jorikdima/pool/case/pcb.FCStd

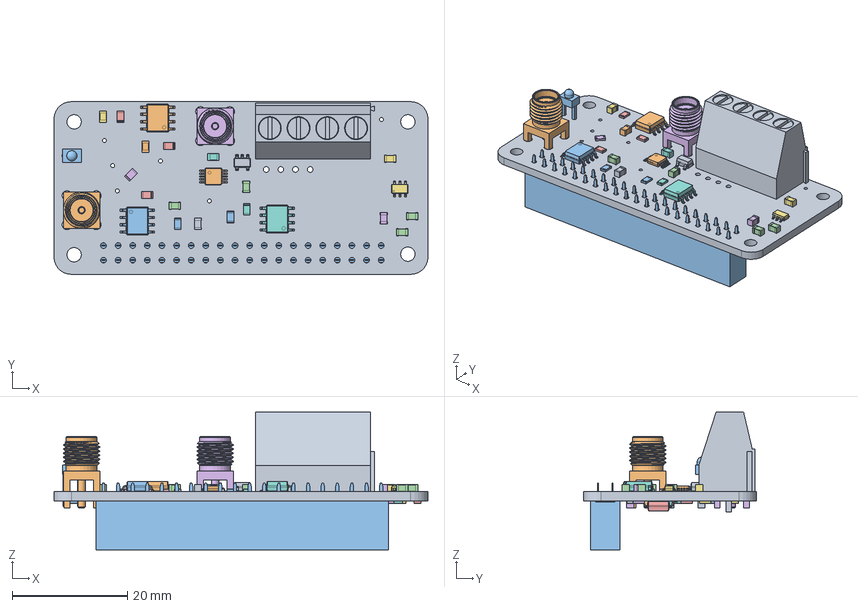
[picture p2: CAD file, 2026-05-02]
case/pcb.FCStd
65.0 x 30.0 x 23.9 mm
Pcb_4311
J2_SMA_Amphenol_132134-11_Vertical_72661cf283ca
D1_LED_D1.8mm_W3.3mm_H2.4mm_6bf1fc921708
C8_C_0805_2012Metric_d904a494b3f4
R5_R_0805_2012Metric_8d37b84ecc4e
C2_C_0805_2012Metric_3a2e4188a297
C5_C_0805_2012Metric_8c90f64f1577
C11_C_0805_2012Metric_bafed0a6da60
J5_TerminalBlock_Phoenix_MKDS_15_4_1x04_P500mm_Horizontal_b8ce8e763538
C9_C_0805_2012Metric_7eb5338fcb41
U2_SOIC-8_3.9x4.9mm_P1.27mm_2550f2f39244
C10_C_0805_2012Metric_abaf07eaa9fc
R7_R_0805_2012Metric_e9da5239a126
J1_SMA_Amphenol_132134-11_Vertical_2cd8d22345b4
C3_C_0805_2012Metric_82abfd312ff3
R16_R_0805_2012Metric_f6691c26e6cb
C6_C_0805_2012Metric_9fc1de177a4e
U1_SOIC-8_3.9x4.9mm_P1.27mm_51985abbd5b2
R8_R_0805_2012Metric_dedefeaef5dd
C4_C_0805_2012Metric_889bce21aff5
R6_R_0805_2012Metric_2ebd9e4347ab
R9_R_0805_2012Metric_04fef424d517
U6_TSOT-23-6_4b1aacd5f09c
U7_SOIC-8_3.9x4.9mm_P1.27mm_beb94b351340
U3_SOT-23-5_a0721606ffa5
U4_TSSOP-10_3x3mm_P0.5mm_04ffdf737e38
R15_R_0805_2012Metric_ebe37478ae97
C1_C_0805_2012Metric_9191a875fa58
U5_SOIC-8_3.9x4.9mm_P1.27mm_6b1703b95a7e
R1_R_0805_2012Metric_da51b3c93e23
R10_R_0805_2012Metric_213238f415b5
R4_R_0805_2012Metric_9aad4cd79e26
R17_R_0805_2012Metric_6fbff45f6105
R12_R_0805_2012Metric_07551a44a8e4
R13_R_0805_2012Metric_59f227cf37c0
R11_R_0805_2012Metric_712be630412e
R3_R_0805_2012Metric_37c15d3d4615
C13_C_0805_2012Metric_2cca7952e8c8
R2_R_0805_2012Metric_f6ddbbc95152
C12_C_0805_2012Metric_ab900ac9c869
C7_C_0805_2012Metric_8e6ad15c78c4
C14_C_0805_2012Metric_feff4e1ea039
J4_PinSocket_2x20_P2.54mm_Vertical_2164e223c993
