jorikdima/pool/(list of files, drawings)

Other design files:
board/sbvm925/TLV75801P_TRANS.DSN
board/sbvm925/TLV75801P_TRANS.OLB
board/sbvm925/TLV75801P_TRANS.opj
board/TLV2372_PSPICE_AIO/TLV2372.DSN
board/TLV2372_PSPICE_AIO/TLV2372.OLB
board/TLV2372_PSPICE_AIO/TLV2372.opj
