jorikdima/pool/board/pool/pool.kicad_pcb

## KiCad design board/pool/pool.kicad_pcb (2026-05-03)

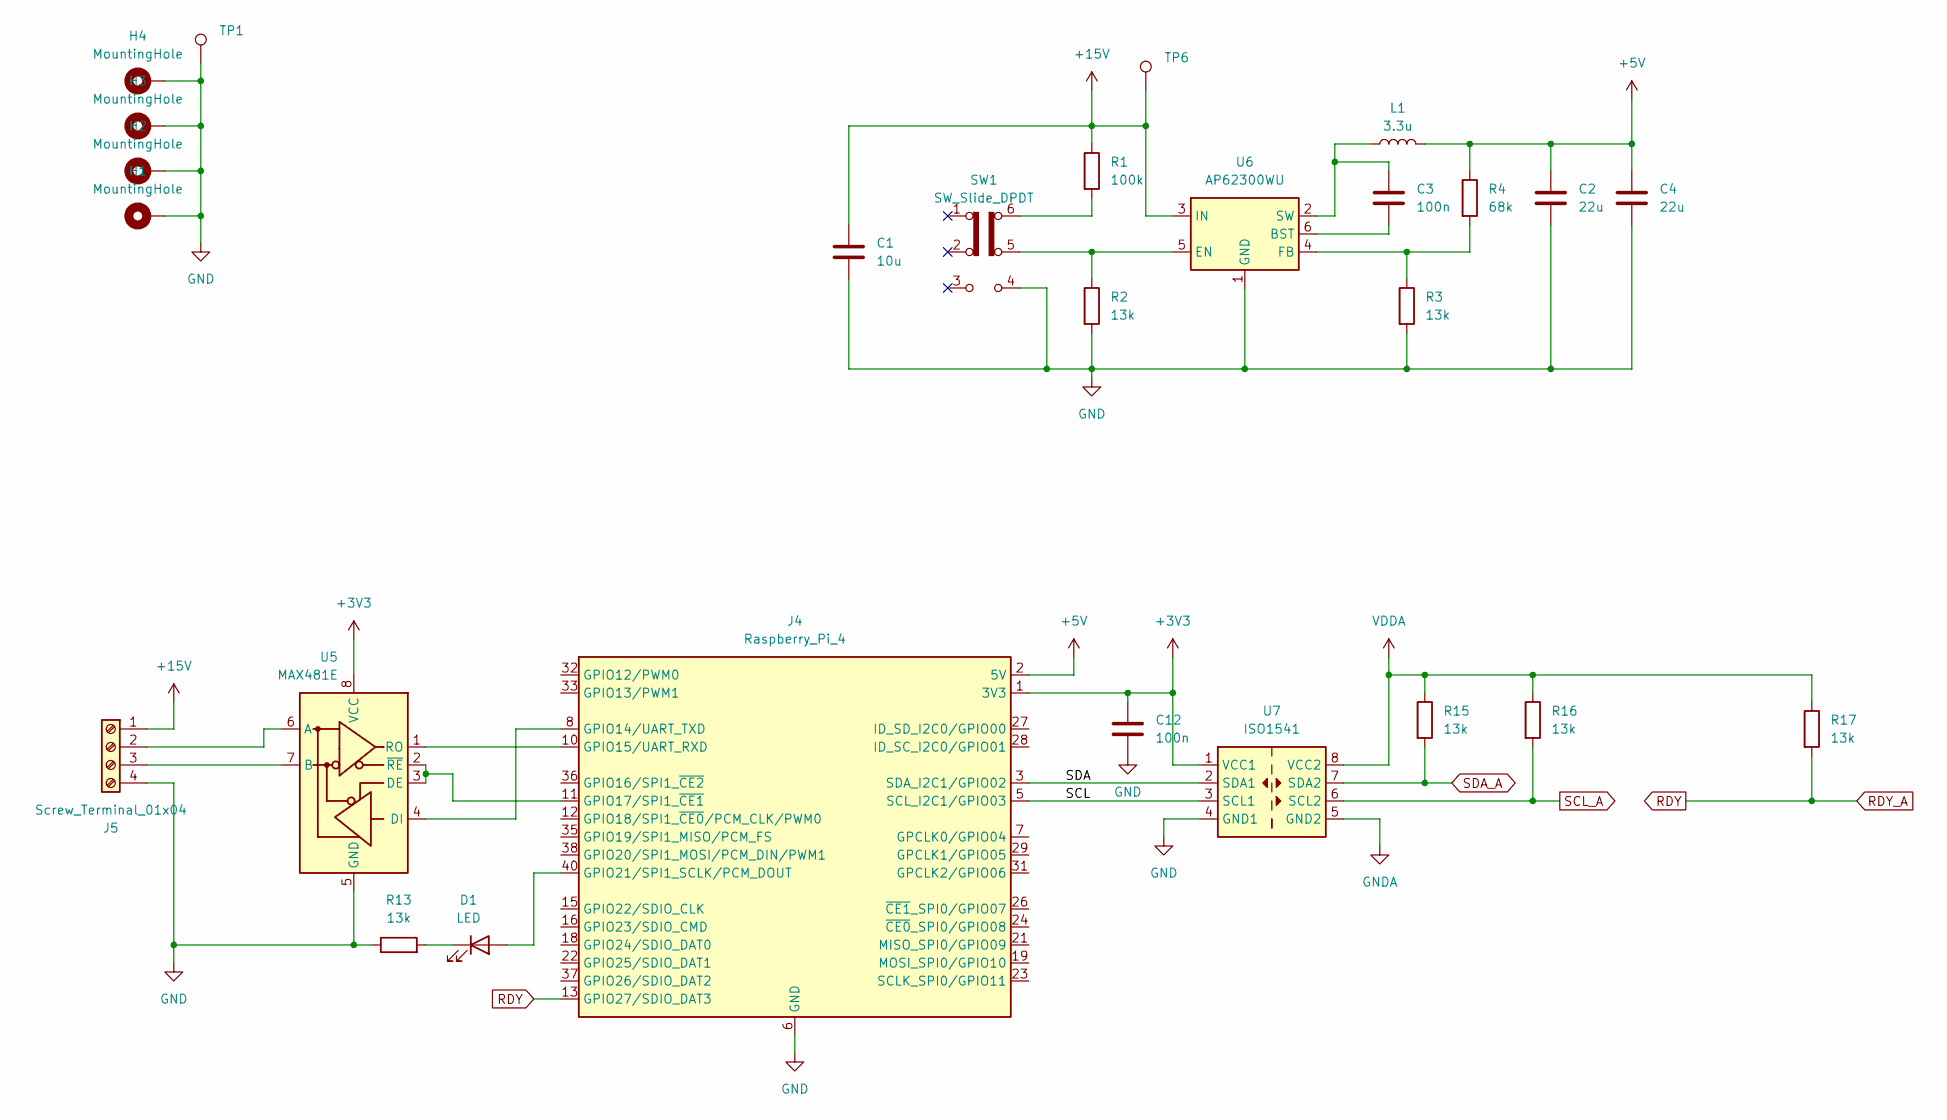
[picture p3: schematic digital.kicad_sch]

Parts:
C1: 10u; C_0805_2012Metric_Pad1.18x1.45mm_HandSolder
C2, C4: 22u; C_0805_2012Metric_Pad1.18x1.45mm_HandSolder
C3, C12: 100n; C_0805_2012Metric_Pad1.18x1.45mm_HandSolder
D1: LED; LED_D1.8mm_W3.3mm_H2.4mm
H1, H2, H3, H4: MountingHole; MountingHole_2.5mm_Pad_TopBottom
J4: Raspberry_Pi_4; PinSocket_2x20_P2.54mm_Vertical
J5: Screw_Terminal_01x04; TerminalBlock_Phoenix_MKDS-1,5-4_1x04_P5.00mm_Horizontal
L1: 3.3u; L_Taiyo-Yuden_NR-80xx_HandSoldering
R1: 100k; R_0805_2012Metric_Pad1.20x1.40mm_HandSolder
R2, R3, R13, R15, R16, R17: 13k; R_0805_2012Metric_Pad1.20x1.40mm_HandSolder
R4: 68k; R_0805_2012Metric_Pad1.20x1.40mm_HandSolder
SW1: SW_Slide_DPDT; CL-SB-22A
TP1: TestPoint; TestPoint_Pad_2.0x2.0mm
TP6: TestPoint; TestPoint_THTPad_1.5x1.5mm_Drill0.7mm
U5: MAX481E; SOIC-8_3.9x4.9mm_P1.27mm
U6: AP62300WU; TSOT-23-6
U7: ISO1541; SOIC-8_3.9x4.9mm_P1.27mm

Connections:
+3V3: C12.1, J4.1 (3V3), J4.17 (3V3), U5.8 (VCC), U7.1 (VCC1)
+5V: C2.1, C4.1, J4.2 (5V), J4.4 (5V), L1.2, R4.1; also elsewhere on the board
+15V: C1.1, J5.1, R1.1, TP6.1, U6.3 (IN)
/digital/SCL: J4.5 (SCL_I2C1/GPIO03), U7.3 (SCL1)
/digital/SDA: J4.3 (SDA_I2C1/GPIO02), U7.2 (SDA1)
GND: C1.2, C2.2, C4.2, C12.2, H1.1, H2.1, H3.1, H4.1, J4.6 (GND), J4.9 (GND), J4.14 (GND), J4.20 (GND), J4.25 (GND), J4.30 (GND), J4.34 (GND), J4.39 (GND), J5.4, R2.2, R3.2, R13.1, SW1.4 (A), TP1.1, U5.5 (GND), U6.1 (GND), U7.4 (GND1); also elsewhere on the board
GNDA: U7.5 (GND2); also elsewhere on the board
unnamed: D1.2 (A), J4.40 (GPIO21/SPI1_SCLK/PCM_DOUT)
unnamed: D1.1 (K), R13.2
unnamed: J4.8 (GPIO14/UART_TXD), U5.4 (DI)
unnamed: J4.10 (GPIO15/UART_RXD), U5.1 (RO)
unnamed: J4.11 (GPIO17/SPI1_~CE1), U5.2 (~RE), U5.3 (DE)
unnamed: J5.2, U5.6 (A)
unnamed: J5.3, U5.7 (B)
unnamed: R1.2, SW1.6 (C)
unnamed: C3.1, U6.6 (BST)
unnamed: R2.1, SW1.5 (B), U6.5 (EN)
unnamed: R3.1, R4.2, U6.4 (FB)
unnamed: C3.2, L1.1, U6.2 (SW)
RDY: J4.13 (GPIO27/SDIO_DAT3), R17.2; also elsewhere on the board
SCL_A: R16.2, U7.6 (SCL2); also elsewhere on the board
SDA_A: R15.2, U7.7 (SDA2); also elsewhere on the board
VDDA: R15.1, R16.1, R17.1, U7.8 (VCC2); also elsewhere on the board

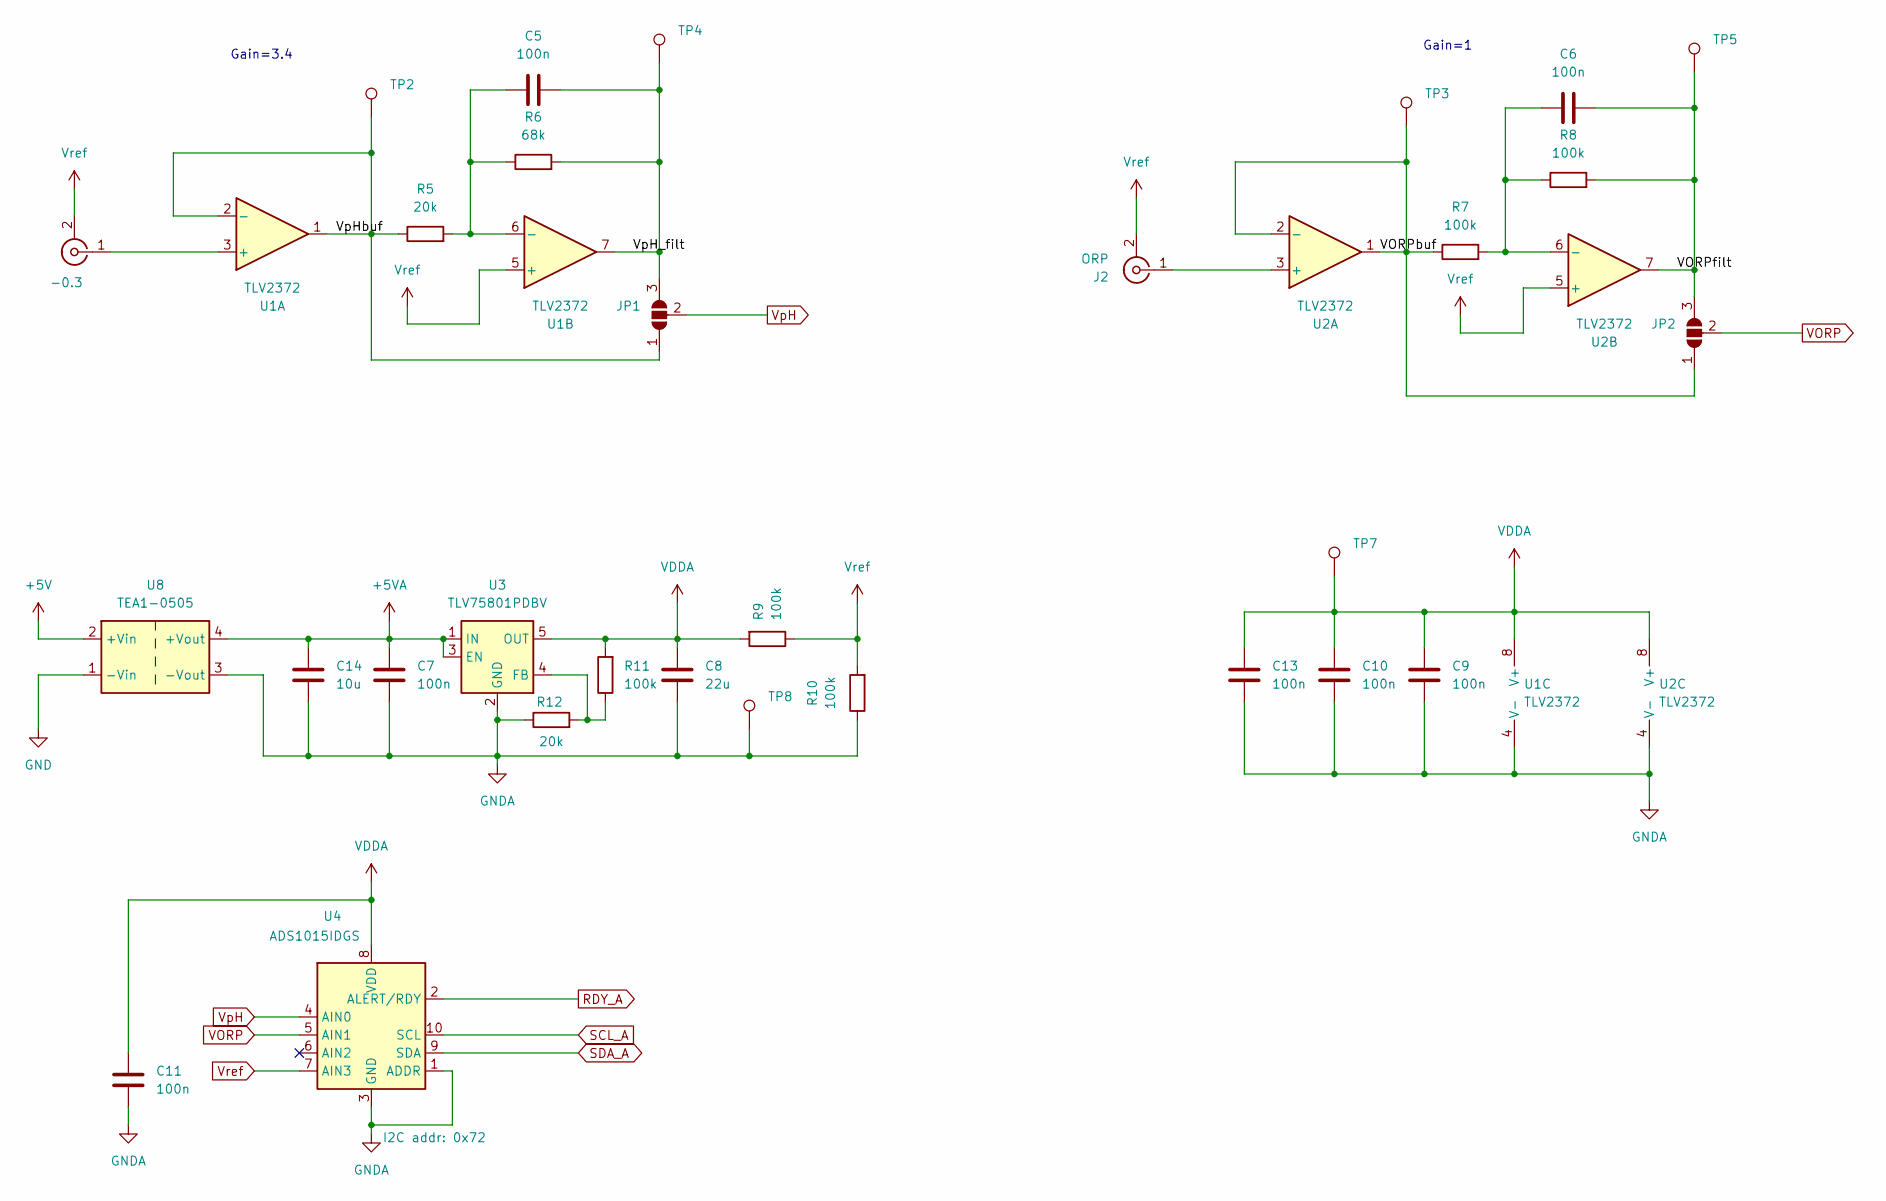
[picture p4: schematic analog.kicad_sch]

Parts:
C5, C6, C7, C9, C10, C11, C13: 100n; C_0805_2012Metric_Pad1.18x1.45mm_HandSolder
C8: 22u; C_0805_2012Metric_Pad1.18x1.45mm_HandSolder
C14: 10u; C_0805_2012Metric_Pad1.18x1.45mm_HandSolder
J1: -0.3; SMA_Amphenol_132134-11_Vertical
J2: ORP; SMA_Amphenol_132134-11_Vertical
JP1, JP2: SolderJumper_3_Open; SolderJumper-3_P1.3mm_Open_Pad1.0x1.5mm_NumberLabels
R5, R12: 20k; R_0805_2012Metric_Pad1.20x1.40mm_HandSolder
R6: 68k; R_0805_2012Metric_Pad1.20x1.40mm_HandSolder
R7, R8, R9, R10, R11: 100k; R_0805_2012Metric_Pad1.20x1.40mm_HandSolder
TP2, TP3, TP4, TP5: TestPoint; TestPoint_THTPad_1.5x1.5mm_Drill0.7mm
TP7: GNDA; TestPoint_THTPad_1.5x1.5mm_Drill0.7mm
TP8: GNDA; TestPoint_Pad_2.0x2.0mm
U1, U2: TLV2372; SOIC-8_3.9x4.9mm_P1.27mm
U3: TLV75801PDBV; SOT-23-5
U4: ADS1015IDGS; TSSOP-10_3x3mm_P0.5mm
U8: TEA1-0505; Converter_DCDC_TRACO_TEA1-xxxx_THT

Connections:
+5V: U8.2 (+Vin); also elsewhere on the board
+5VA: C7.1, C14.1, U3.1 (IN), U3.3 (EN), U8.4 (+Vout)
/analog/VORPbuf: JP2.1 (A), R7.1, TP3.1, U2.1, U2.2 (-)
/analog/VORPfilt: C6.1, JP2.3 (B), R8.2, TP5.1, U2.7
/analog/VpH_filt: C5.1, JP1.3 (B), R6.2, TP4.1, U1.7
/analog/VpHbuf: JP1.1 (A), R5.1, TP2.1, U1.1, U1.2 (-)
GND: U8.1 (-Vin); also elsewhere on the board
GNDA: C7.2, C8.1, C9.2, C10.2, C11.2, C13.2, C14.2, R10.1, R12.1, TP8.1, U1.4 (V-), U2.4 (V-), U3.2 (GND), U4.1 (ADDR), U4.3 (GND), U8.3 (-Vout); also elsewhere on the board
unnamed: J1.1 (In), U1.3 (+)
unnamed: J2.1 (In), U2.3 (+)
unnamed: C5.2, R5.2, R6.1, U1.6 (-)
unnamed: C6.2, R7.2, R8.1, U2.6 (-)
unnamed: R11.1, R12.2, U3.4 (FB)
RDY: U4.2 (ALERT/RDY); also elsewhere on the board
SCL_A: U4.10 (SCL); also elsewhere on the board
SDA_A: U4.9 (SDA); also elsewhere on the board
VDDA: C8.2, C9.1, C10.1, C11.1, C13.1, R9.2, R11.2, TP7.1, U1.8 (V+), U2.8 (V+), U3.5 (OUT), U4.8 (VDD); also elsewhere on the board
VORP: JP2.2 (C), U4.5 (AIN1)
VpH: JP1.2 (C), U4.4 (AIN0)
Vref: J1.2 (Ext), J2.2 (Ext), R9.1, R10.2, U1.5 (+), U2.5 (+), U4.7 (AIN3)

Notes on the sheet:
Gain=1
Gain=3.4

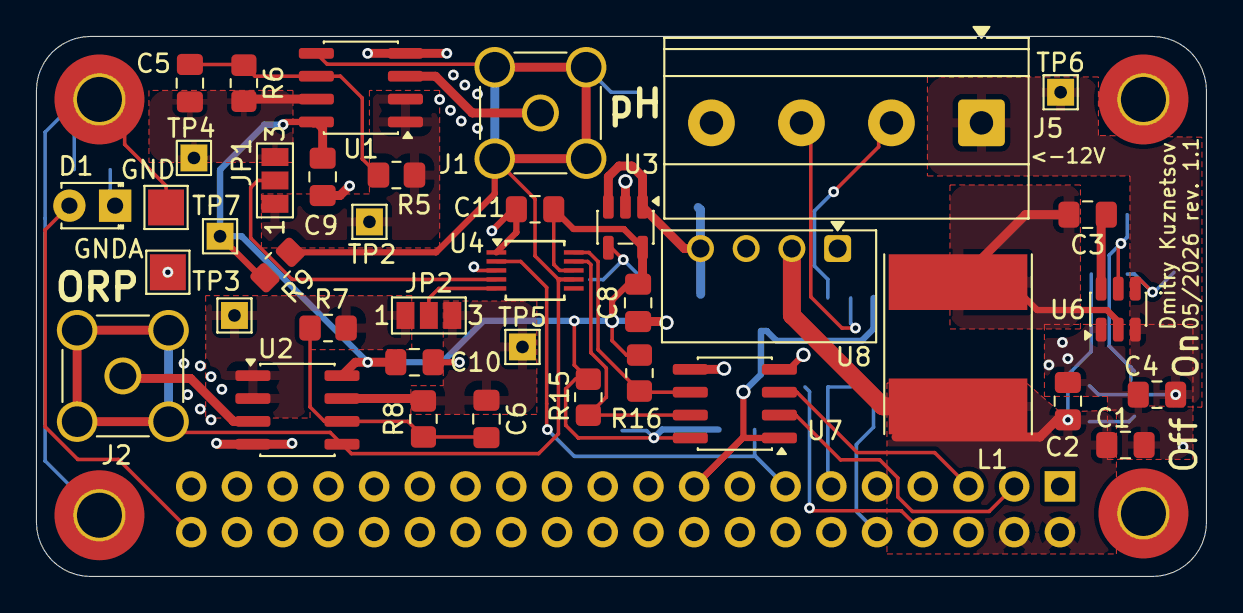
[picture p5: board pool.kicad_pcb from above]

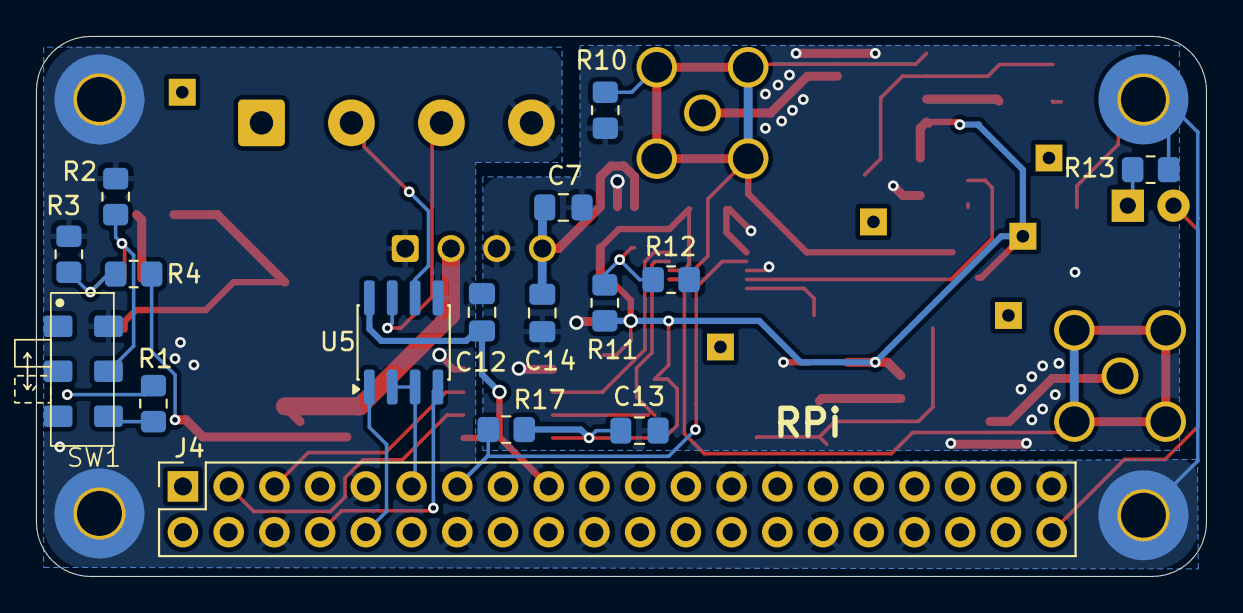
[picture p6: board pool.kicad_pcb from below]

Board: 2 copper layers, 65.0 x 30.0 mm, 59 parts (16 on the bottom side), 36 nets.

Other parts of the board:
GND: TestPoint; TestPoint_Pad_2.0x2.0mm
GNDA: GNDA; TestPoint_Pad_2.0x2.0mm

Their connections:
GND: GND.1; also elsewhere on the board
GNDA: GNDA.1; also elsewhere on the board
