jorikdima/pool/(commit log)

2026-04-26 Added rev 1.1 of the board
    [analog.kicad_sch, digital.kicad_sch, pool.kicad_pcb]
2026-05-02 Initial release of the case design. No latches so far
    [case.FCStd, pcb.FCStd]
2026-05-02 Add a datasheet for the power converter
2026-05-03 Final version of the enclosure
    [case.FCStd, pool.kicad_pcb]
